Ermakov/CrealitySpacePiAutomation/SpacePiModule3.jpg

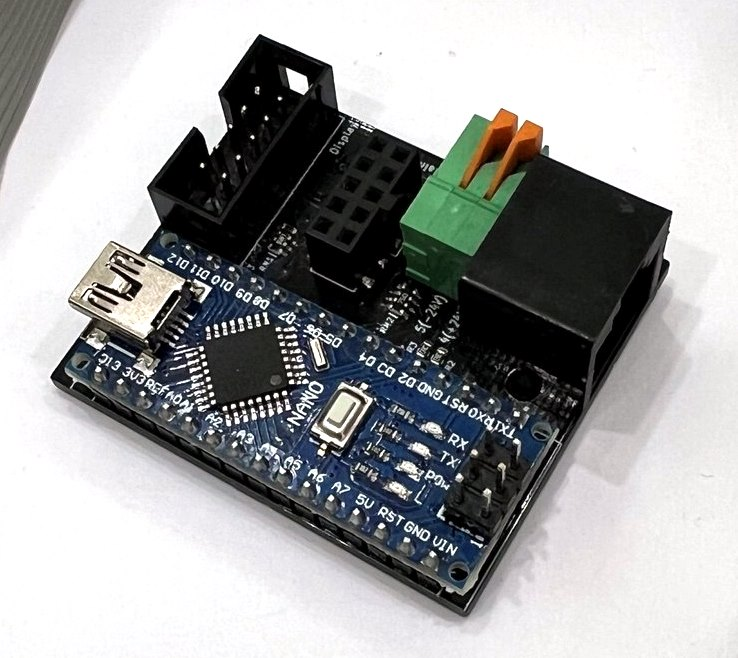
SpacePiModule3.jpg
