Ermakov/CrealitySpacePiAutomation/SpacePiModule5.jpg

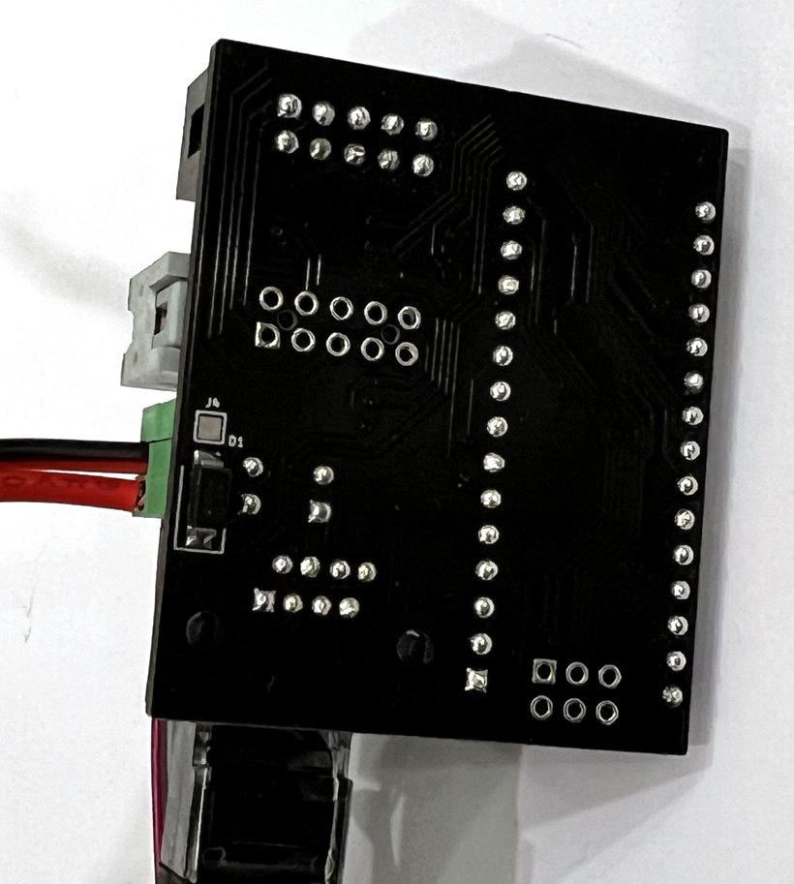
SpacePiModule5.jpg
