Ermakov/CrealitySpacePiAutomation/SpacePiModule1.jpg

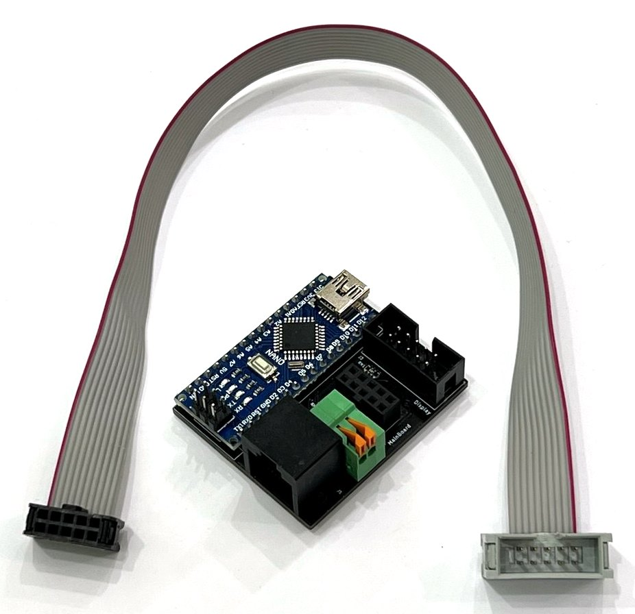
SpacePiModule1.jpg
