Ermakov/CrealitySpacePiAutomation/SpacePiModule2.jpg

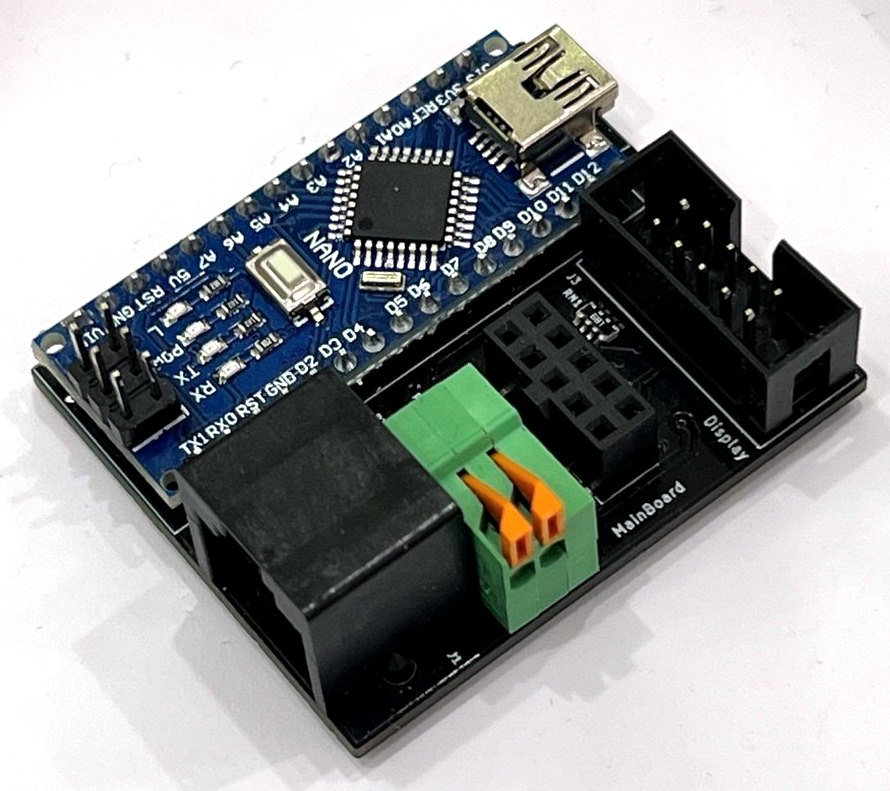
SpacePiModule2.jpg
