Ermakov/CrealitySpacePiAutomation/SpacePiModule4.jpg

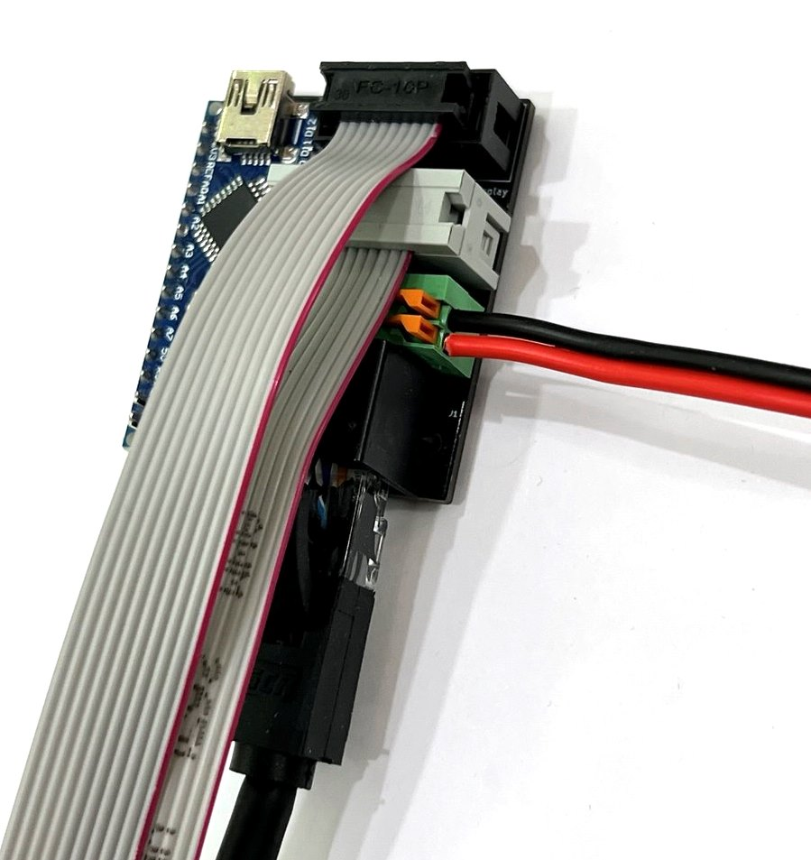
SpacePiModule4.jpg
