Ermakov/CrealitySpacePiAutomation/CrealityDryerArduinoPCB(KiCad8)/CrealityDryerV1.kicad_pcb

## KiCad design CrealityDryerArduinoPCB(KiCad8)/CrealityDryerV1.kicad_pcb (2025-08-09)

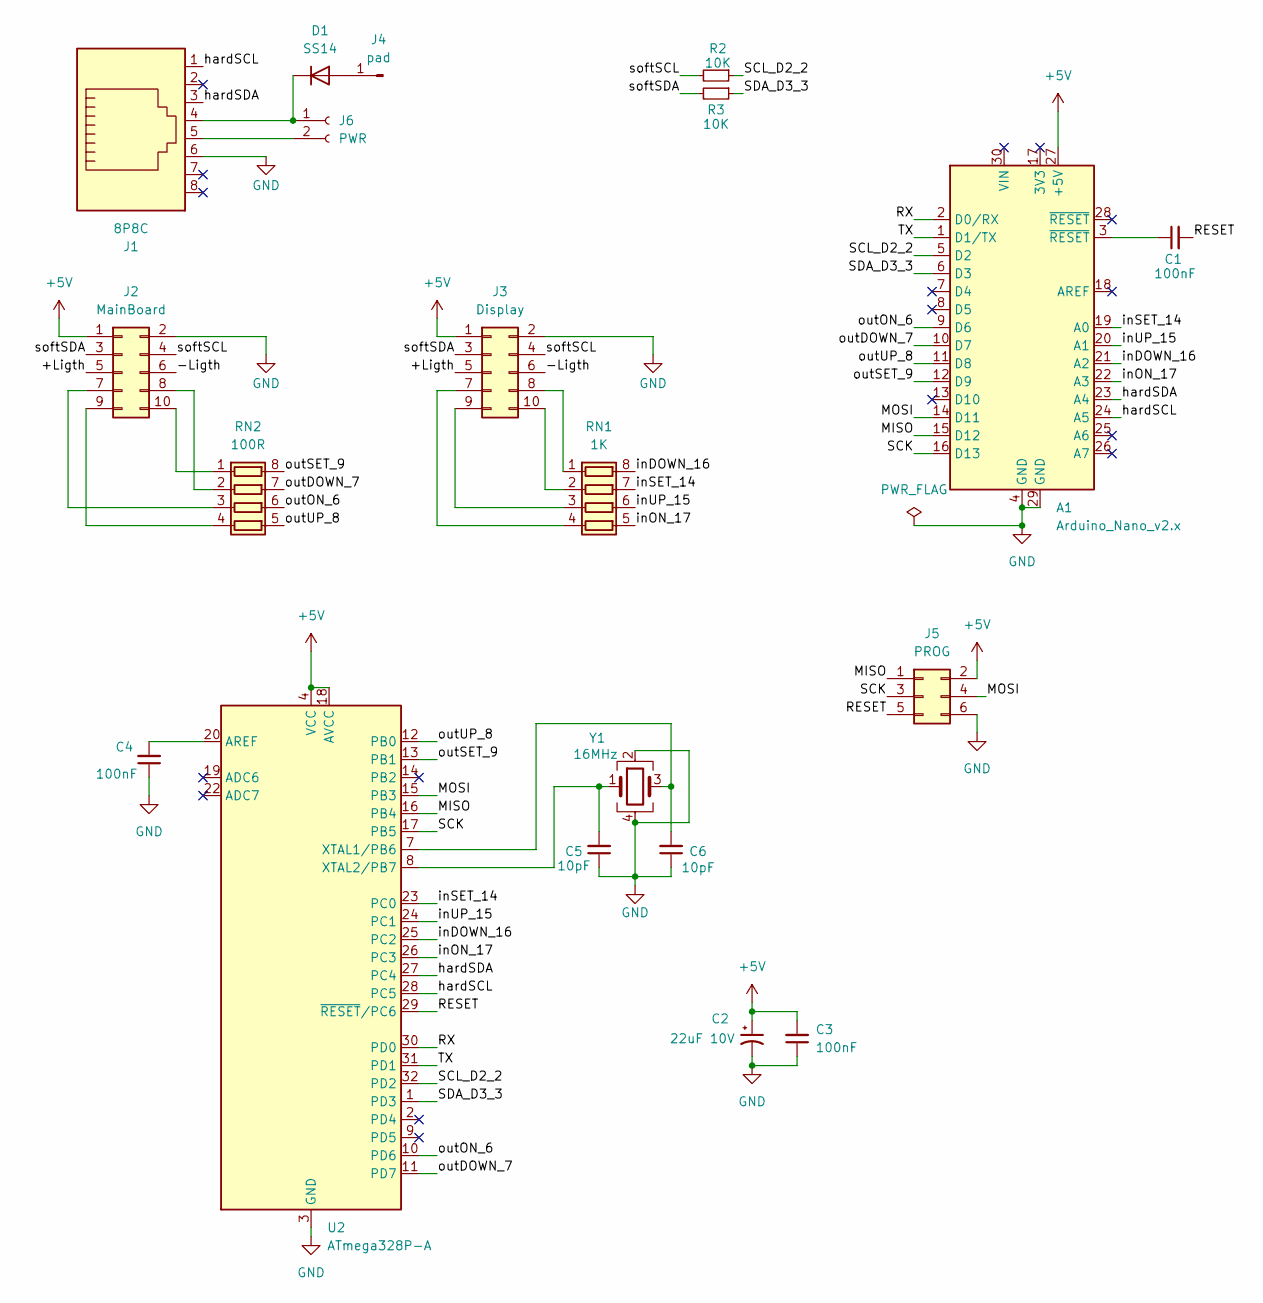
[picture p6: schematic CrealityDryerV1.kicad_sch]

Parts:
A1: Arduino_Nano_v2.x; Arduino_Nano
C1, C3, C4: 100nF; C_0603_1608Metric
C2: 22uF 10V; CP_EIA-3528-12_Kemet-T
C5, C6: 10pF; C_0603_1608Metric
D1: SS14; D_SMA
J1: 8P8C; RJ45_OST_PJ012-8P8CX_VerticalSensor
J2: MainBoard; IDC-Famale_2x05_P2.54mm_VerticalSilk
J3: Display; IDC-Header_2x05_P2.54mm_VerticalSilk
J4: pad; TestPoint_Pad_1.5x1.5mm
J5: PROG; PinHeader_2x03_P2.54mm_Vertical
J6: PWR; DG141R-2.54-02P
R2, R3: 10K; R_0603_1608Metric
RN1: 1K; R_Array_Convex_4x0603
RN2: 100R; R_Array_Convex_4x0603
U2: ATmega328P-A; TQFP-32_7x7mm_P0.8mm
Y1: 16MHz; Crystal_SMD_3225-4Pin_3.2x2.5mm

Connections:
+5V: A1.27 (+5V), C2.1, C3.2, J2.1, J3.1, J5.2, U2.4 (VCC), U2.6 (VCC), U2.18 (AVCC)
/+Ligth: J2.5, J3.5
/-Ligth: J2.6, J3.6
/MISO: A1.15 (D12), J5.1, U2.16 (PB4)
/MOSI: A1.14 (D11), J5.4, U2.15 (PB3)
/RESET: C1.2, J5.5, U2.29 (~RESET/PC6)
/RX: A1.2 (D0/RX), U2.30 (PD0)
/SCK: A1.16 (D13), J5.3, U2.17 (PB5)
/SCL_D2_2: A1.5 (D2), R2.1, U2.32 (PD2)
/SDA_D3_3: A1.6 (D3), R3.1, U2.1 (PD3)
/TX: A1.1 (D1/TX), U2.31 (PD1)
/hardSCL: A1.24 (A5), J1.1, U2.28 (PC5)
/hardSDA: A1.23 (A4), J1.3, U2.27 (PC4)
/inDOWN_16: A1.21 (A2), RN1.8 (R1.2), U2.25 (PC2)
/inON_17: A1.22 (A3), RN1.5 (R4.2), U2.26 (PC3)
/inSET_14: A1.19 (A0), RN1.7 (R2.2), U2.23 (PC0)
/inUP_15: A1.20 (A1), RN1.6 (R3.2), U2.24 (PC1)
/outDOWN_7: A1.10 (D7), RN2.7 (R2.2), U2.11 (PD7)
/outON_6: A1.9 (D6), RN2.6 (R3.2), U2.10 (PD6)
/outSET_9: A1.12 (D9), RN2.8 (R1.2), U2.13 (PB1)
/outUP_8: A1.11 (D8), RN2.5 (R4.2), U2.12 (PB0)
/softSCL: J2.4, J3.4, R2.2
/softSDA: J2.3, J3.3, R3.2
GND: A1.4 (GND), A1.29 (GND), C2.2, C3.1, C4.1, C5.1, C6.1, J1.6, J2.2, J3.2, J5.6, U2.3 (GND), U2.5 (GND), U2.21 (GND), Y1.2, Y1.4
unnamed: A1.3 (~RESET), C1.1
unnamed: D1.2 (A), J4.1
unnamed: D1.1 (K), J1.4, J6.1
unnamed: J2.7, RN2.3 (R3.1)
unnamed: J2.8, RN2.2 (R2.1)
unnamed: J2.9, RN2.4 (R4.1)
unnamed: J2.10, RN2.1 (R1.1)
unnamed: J3.7, RN1.4 (R4.1)
unnamed: J3.8, RN1.1 (R1.1)
unnamed: J3.9, RN1.3 (R3.1)
unnamed: J3.10, RN1.2 (R2.1)
unnamed: J1.5, J6.2
unnamed: C4.2, U2.20 (AREF)
unnamed: C6.2, U2.7 (XTAL1/PB6), Y1.3
unnamed: C5.2, U2.8 (XTAL2/PB7), Y1.1

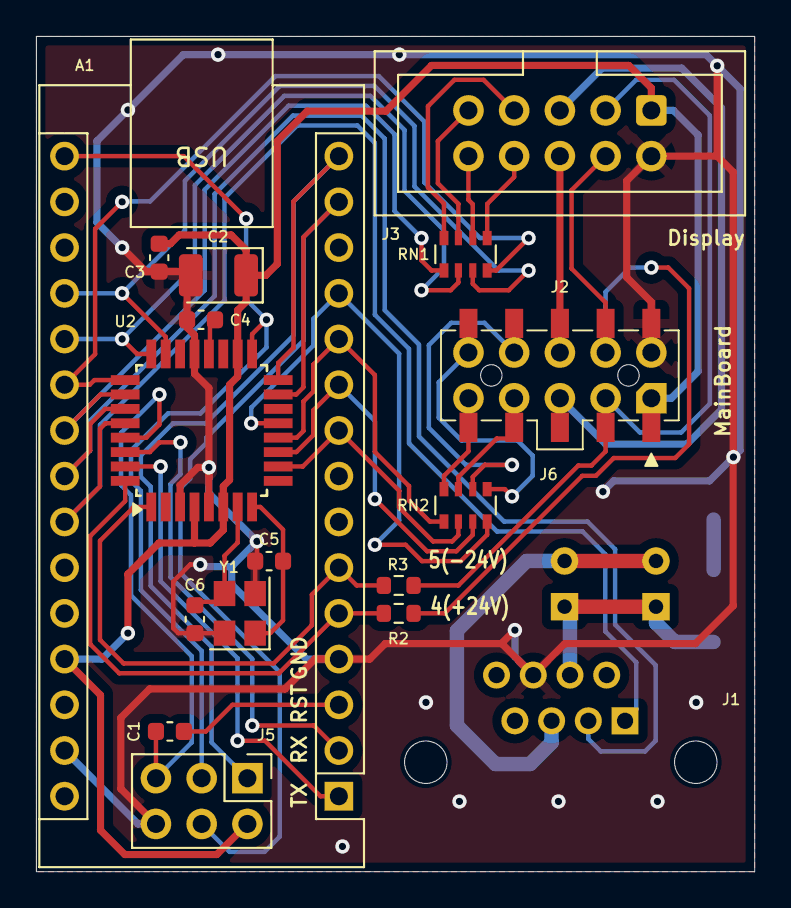
[picture p7: board CrealityDryerV1.kicad_pcb from above]

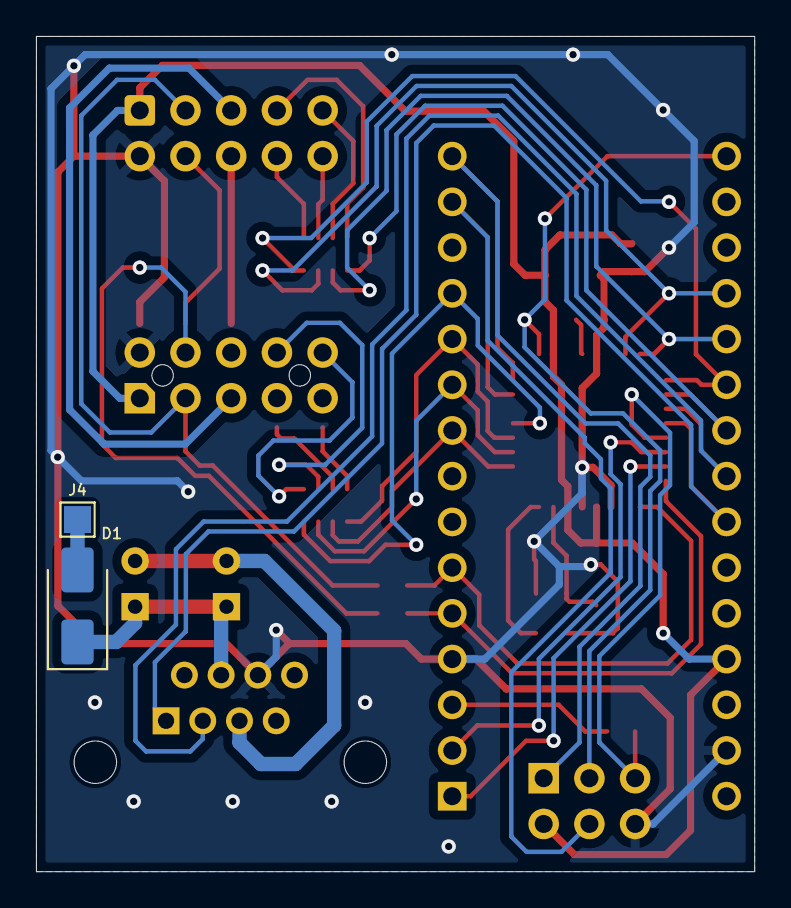
[picture p8: board CrealityDryerV1.kicad_pcb from below]

Board: 2 copper layers, 39.9 x 46.4 mm, 20 parts (2 on the bottom side), 39 nets.
